xandero1/Linefollower/bill of materials/readme.md

## bill of materials
<br />

|volgnummer|naam|omschrijving|nieuw/recup|kostprijs/stuk|aantal|subtotaal|
|---|----|---|---|---|---|---|
|1 |Microcontroller|Arduino nano (Atmega328)|Nieuw|€5,4|1|€5,4|
|2 |H-brug |DRV8833 |Nieuw |€6,5 |1 |€6,5 |
|3 |Sensoren |QTR-8A |Nieuw |€11,91 |1 |€11,91 |
|4 |Bluetooth module |HC-05 |Nieuw |€4 |1 |€4 |
|5 |Motoren |Gear motor 9V, 50:1 |Nieuw |€5,5 |2 |€11 |
|6 |Wielen |Wielen pair 32x7mm |Nieuw |€4,32 |1 |€4,32 |
|7 |Batterij |Samsung NR18650 |Nieuw |€8,49 |2 |€16,98 |
|8 |LED |Blauw 5V |Recup |€0 |1 |€0 |
|9 |Drukknop |Drukknop |Recup |€0 |1 |€0 |
|10 |Schakelaar |Mini tuimelschekalaar  |Recup |€0 |1 |€0 |
|11 |Weerstand |220Ω |Recup |€0 |1 |€0 |
|12 |Weerstand |1kΩ |Recup |€0 |1 |€0 |
|13 |Weerstand |10kΩ |Recup |€0 |1 |€0 |
|14 |Prototype board |Double shielded board 60x60mm |Nieuw |€1,5 |1 |€1,5 |
|15 |Frame |MDF Hout |Recup |€0 |1 |€0 |
|16 |Motorbracket |PLA |Nieuw |€0,34 |2 |€0,68  |
|17 |Bouten |Bouten |Recup |€0 |10 |€0 |
|18 |Moeren |Moeren |Recup |€0 |11 |€0 |
|Totaal prijs: €62,29|
