xandero1/Linefollower/bill of materials/Bil of materials.xlsx

Nr. | Naam | Omschrijving | Nieuw/Recup | Prijs/stuk | Aantal | Subtotaal | Link
1 | Microcontroller | Arduino Nano | Nieuw | 5.4 | 1 | 5.4 | https://www.amazon.nl/gp/product/B078S8BJ8T/ref=ppx_yo_dt_b_asin_title_o03_s00?ie=UTF8&psc=1
3 | H-brug | DRV8833 | Nieuw | 6.5 | 1 | 6.5 | https://www.amazon.com/NOYITO-DRV8833-2-Channel-Ultra-small-Voltage/dp/B07FZY8GX2
2 | Sensoren | QTR-8A | Nieuw | 11.91 | 1 | 11.91 | https://botland.store/sensors-odbiciowe/152-qtr-8a-reflectance-sensor-array-analog-pololu-960-5903351249300.html
4 | Bluetooth module | HC-05 | Nieuw | 4 | 1 | 4 | https://www.amazon.nl/gp/product/B07BHRG9KB/ref=ppx_yo_dt_b_asin_title_o03_s00?ie=UTF8&psc=1
5 | Motoren | Gear motor 9V, 50:1 | Nieuw | 5.5 | 2 | 11 | https://botland.store/n20-micro-motors-mp-series-medium-power/12567-micro-motor-n20-bt25-50-1-630rpm-9v-5904422306632.html
6 | Wielen | Wielen pair 32x7mm | Nieuw | 4.32 | 1 | 4.32 | https://botland.store/wheels-with-tires/12-wheels-32x7mm-black-2pcs-pololu-1087-5903351247924.html
7 | Batterij | Samsung NR18650 | Nieuw | 8.49 | 2 | 16.98 | https://www.conrad.be/nl/p/samsung-nr18650-25r-speciale-oplaadbare-batterij-18650-geschikt-voor-hoge-stroomsterktes-geschikt-voor-hoge-temperature-1431335.htm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
8 | Led | Led blauw 5V | Recup | 0 | 1 | 0 | https://www.allekabels.be/led-diode/7369/1086017/blauwe-led-3mm-transparant-2200mcd-20ma.html
9 | Drukknop | Drukknop | Recup | 0 | 1 | 0 | https://www.otronic.nl/a-60343296/schakelaars/drukknopje-moment-6x6x4/
10 | Schakelaar | Mini tuimelschekalaar | Recup | 0 | 1 | 0 | https://www.bol.com/be/nl/p/mini-tuimelschakaar-1p-aan-uit-aan-chroom/9200000115170323/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
11 | Weerstand | Weerstand 220Ω | Recup | 0 | 1 | 0 | https://www.otronic.nl/a-59685595/weerstanden/10x-weerstand-220-ohm-1-4-watt-5-led-voorschakelweerstand/
12 | Weerstand | Weerstand 1kΩ | Recup | 0 | 3 | 0 | https://www.otronic.nl/a-59867443/weerstanden/10x-weerstand-1k-ohm-1-4-watt-5/
13 | Weerstand | Weerstand 10kΩ | Recup | 0 | 1 | 0 | https://www.otronic.nl/a-59867467/weerstanden/10x-weerstand-10k-ohm-1-4-watt-5-pull-up-pull-down/
14 | Prototype board | Double shielded board 60x60mm | Nieuw | 1.5 | 1 | 1.5 | https://botland.store/circuit-boards/2745-universal-double-sided-board-50x70mm-5904422303303.html
15 | Frame | MDF Hout | Recup | 0 | 1 | 0
16 | Motorbracket | PLA | Nieuw | 0.34 | 2 | 0.68
17 | Bouten | Bouten | Recup | 0 | 10 | 0
18 | Moeren | Moeren | Recup | 0 | 11 | 0
Totaal prijs: |  |  |  |  |  | 62.29
