xandero1/Linefollower/code/proof of concepts/hbridge/Elektronisch schema H-brug_2023-08-29.pdf

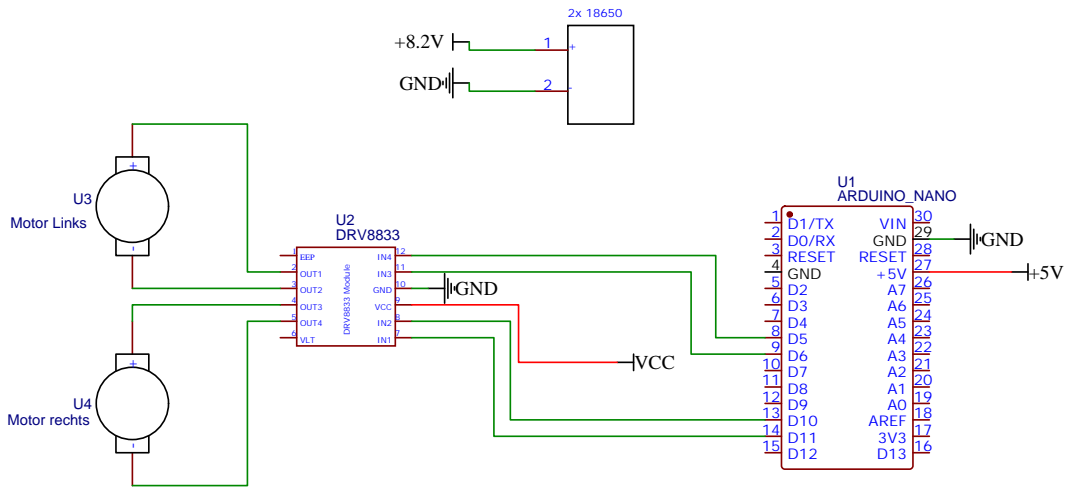
[picture p4: page 1]
