xandero1/Linefollower/code/proof of concepts/interrupt/Elektronisch schema Interrupt.pdf

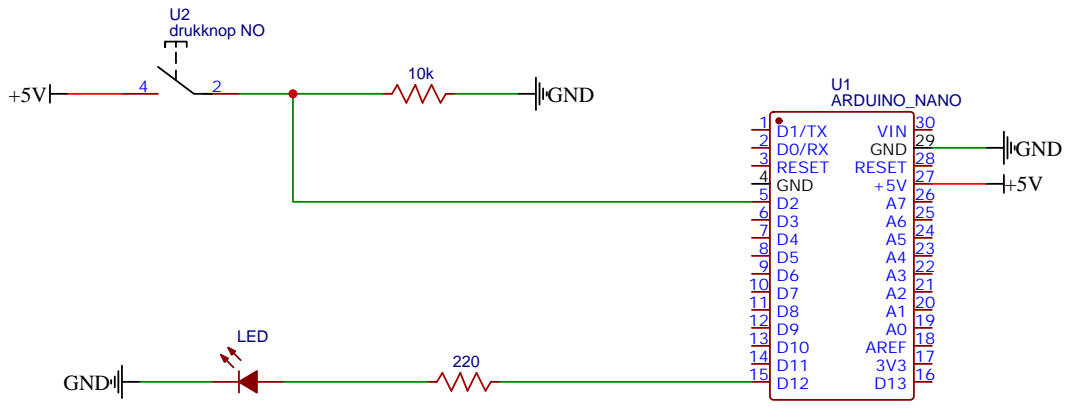
[picture p5: page 1]
