xandero1/Linefollower/code/proof of concepts/wireless communication/Elektronisch schema Draadloze communicatie.pdf

HC05

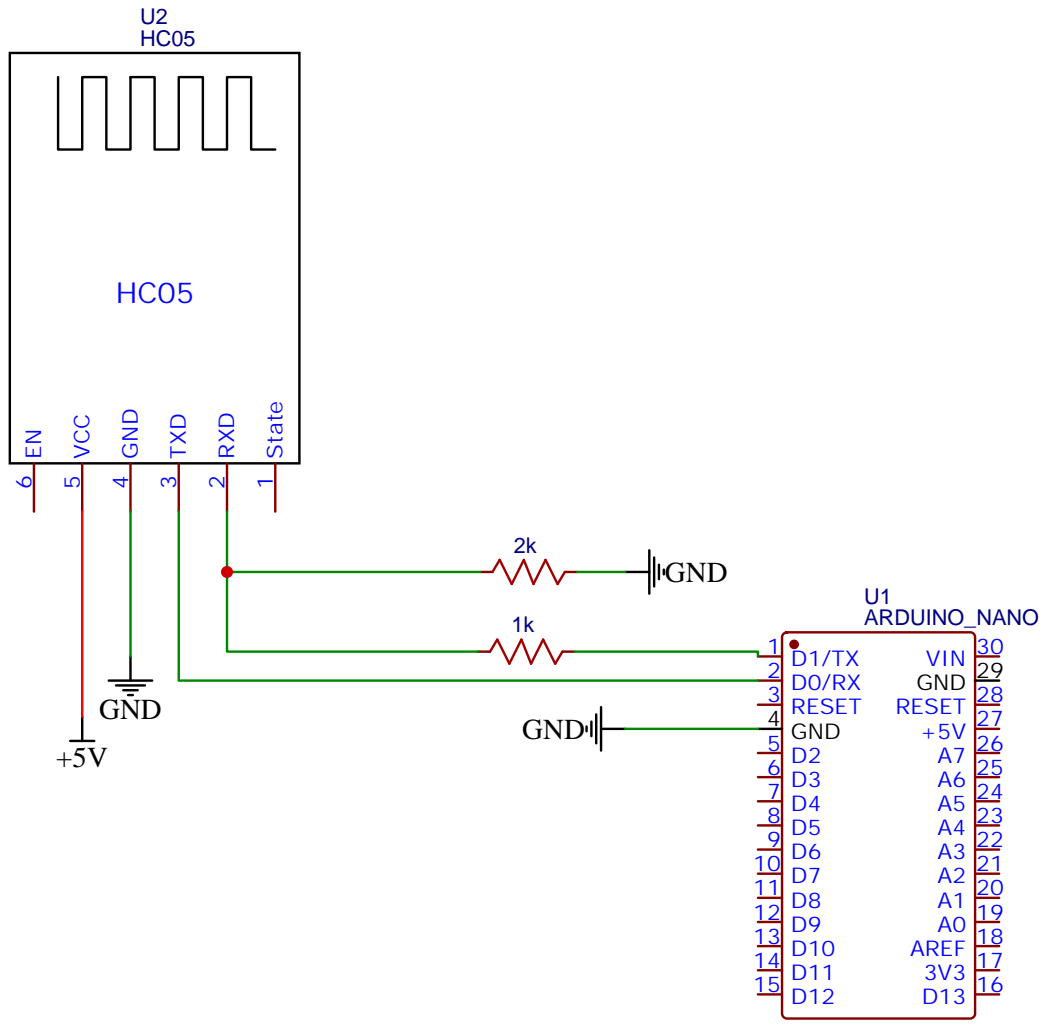
[picture p6: page 1]
