xandero1/Linefollower/code/proof of concepts/sensor/Elektronisch schema QTR-8A.pdf

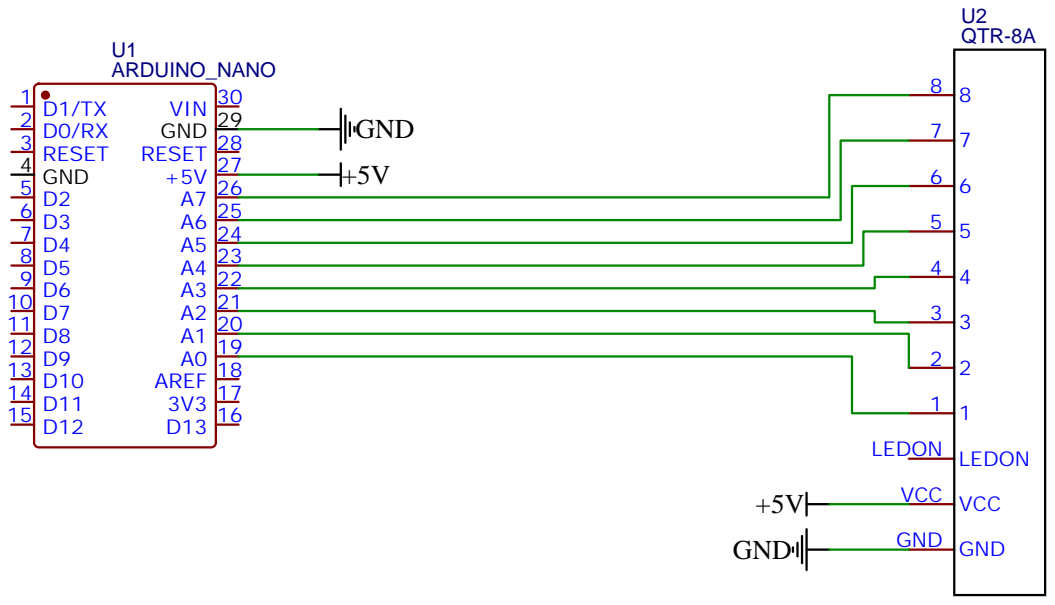
[picture p7: page 1]
