xandero1/Linefollower/technische tekeningen/elektronisch/Elektronisch schema linefolower_2023-08-29.pdf

HC05

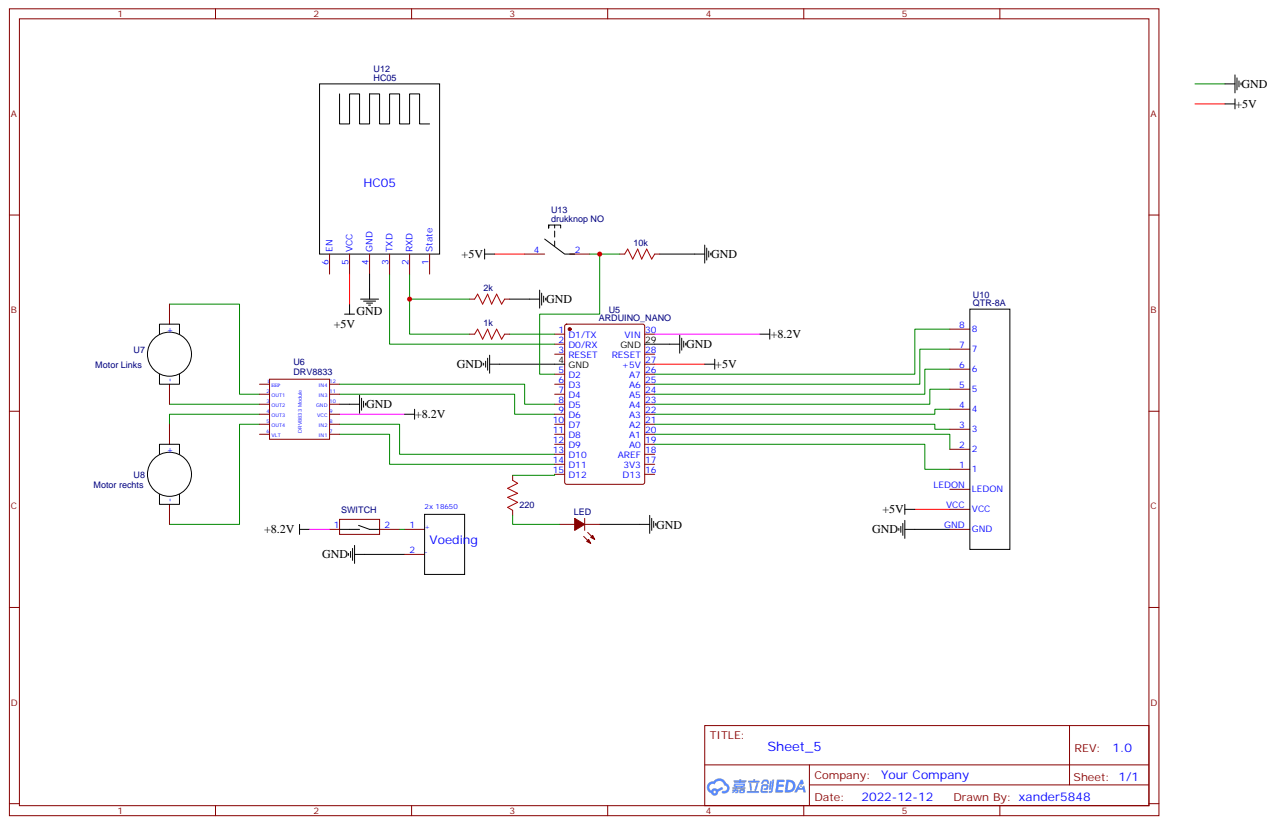
[picture p8: page 1]
